Anim4bot/Hardware/Motherboard - Rev2.pdf

## SWITCHES & LEDS

ACTUATORS | SENSORS

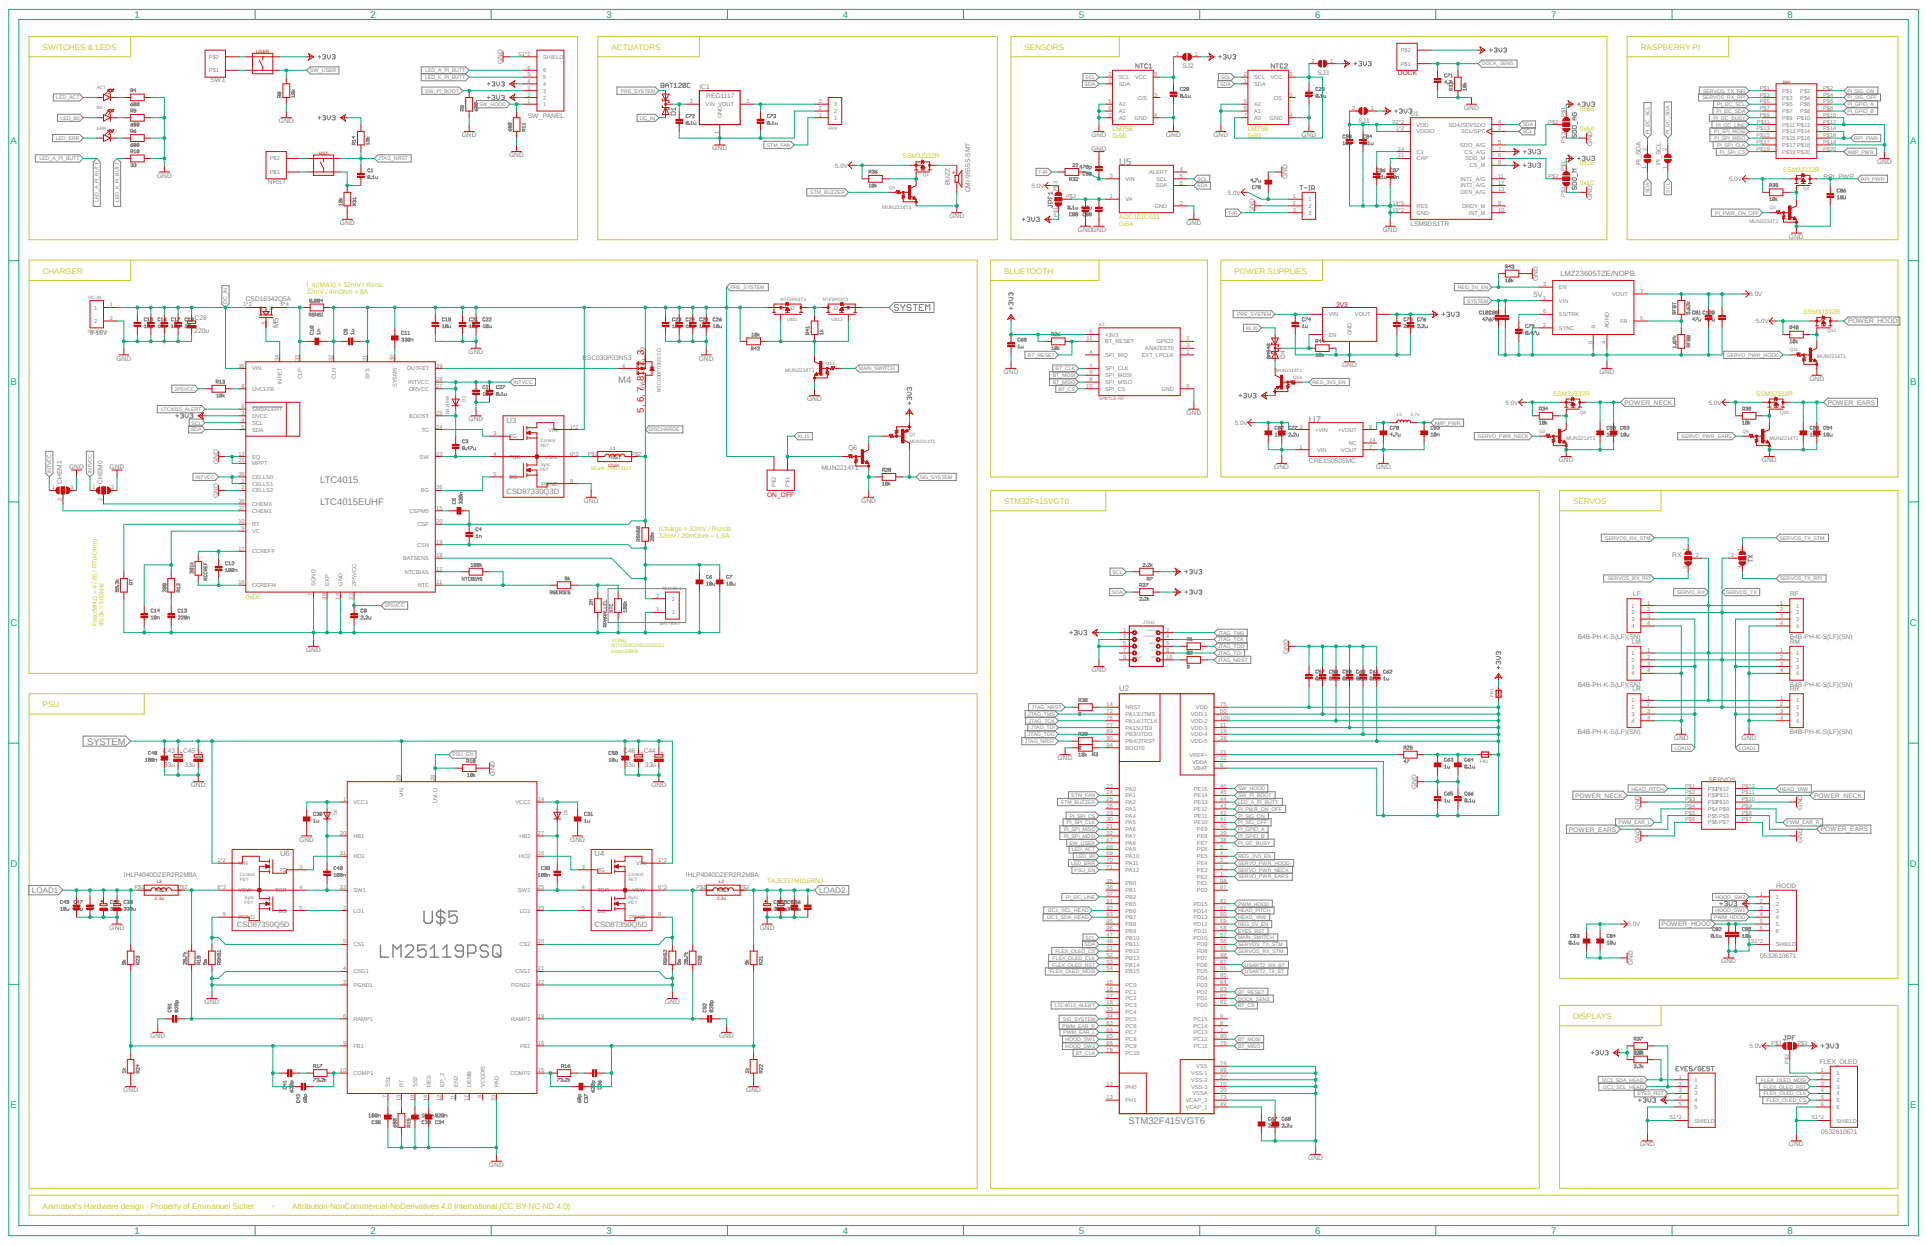
[picture p1: page 1]

Fosc(MHz) = 47.65 / RT(kOhm)
