Anim4bot/Hardware/Motherboard - Rev2.brd

## EAGLE design Motherboard - Rev2.brd (2019-11-18)

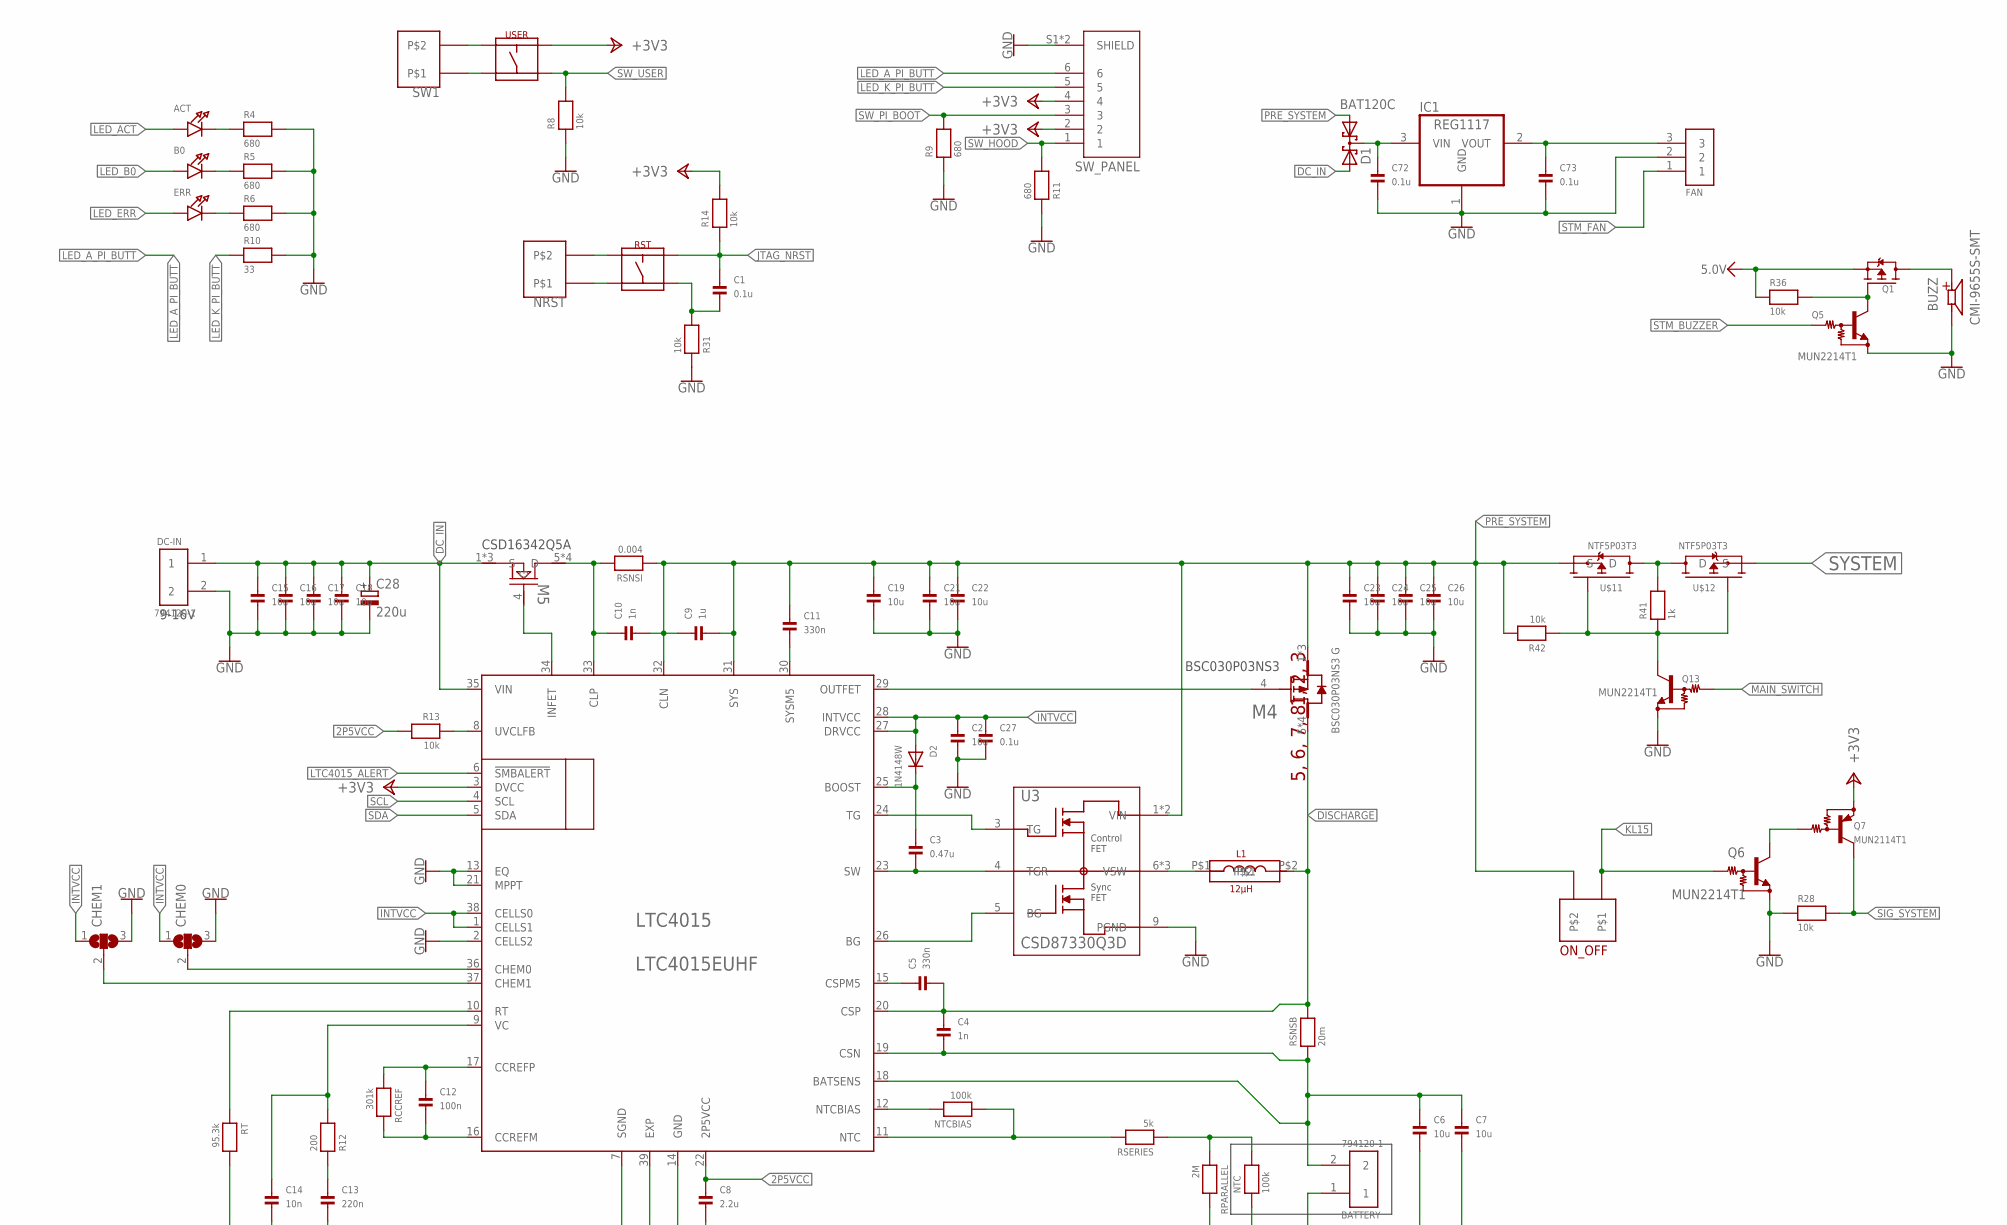
[picture p2: schematic Motherboard - Rev2.sch, part in row 1, column 1]

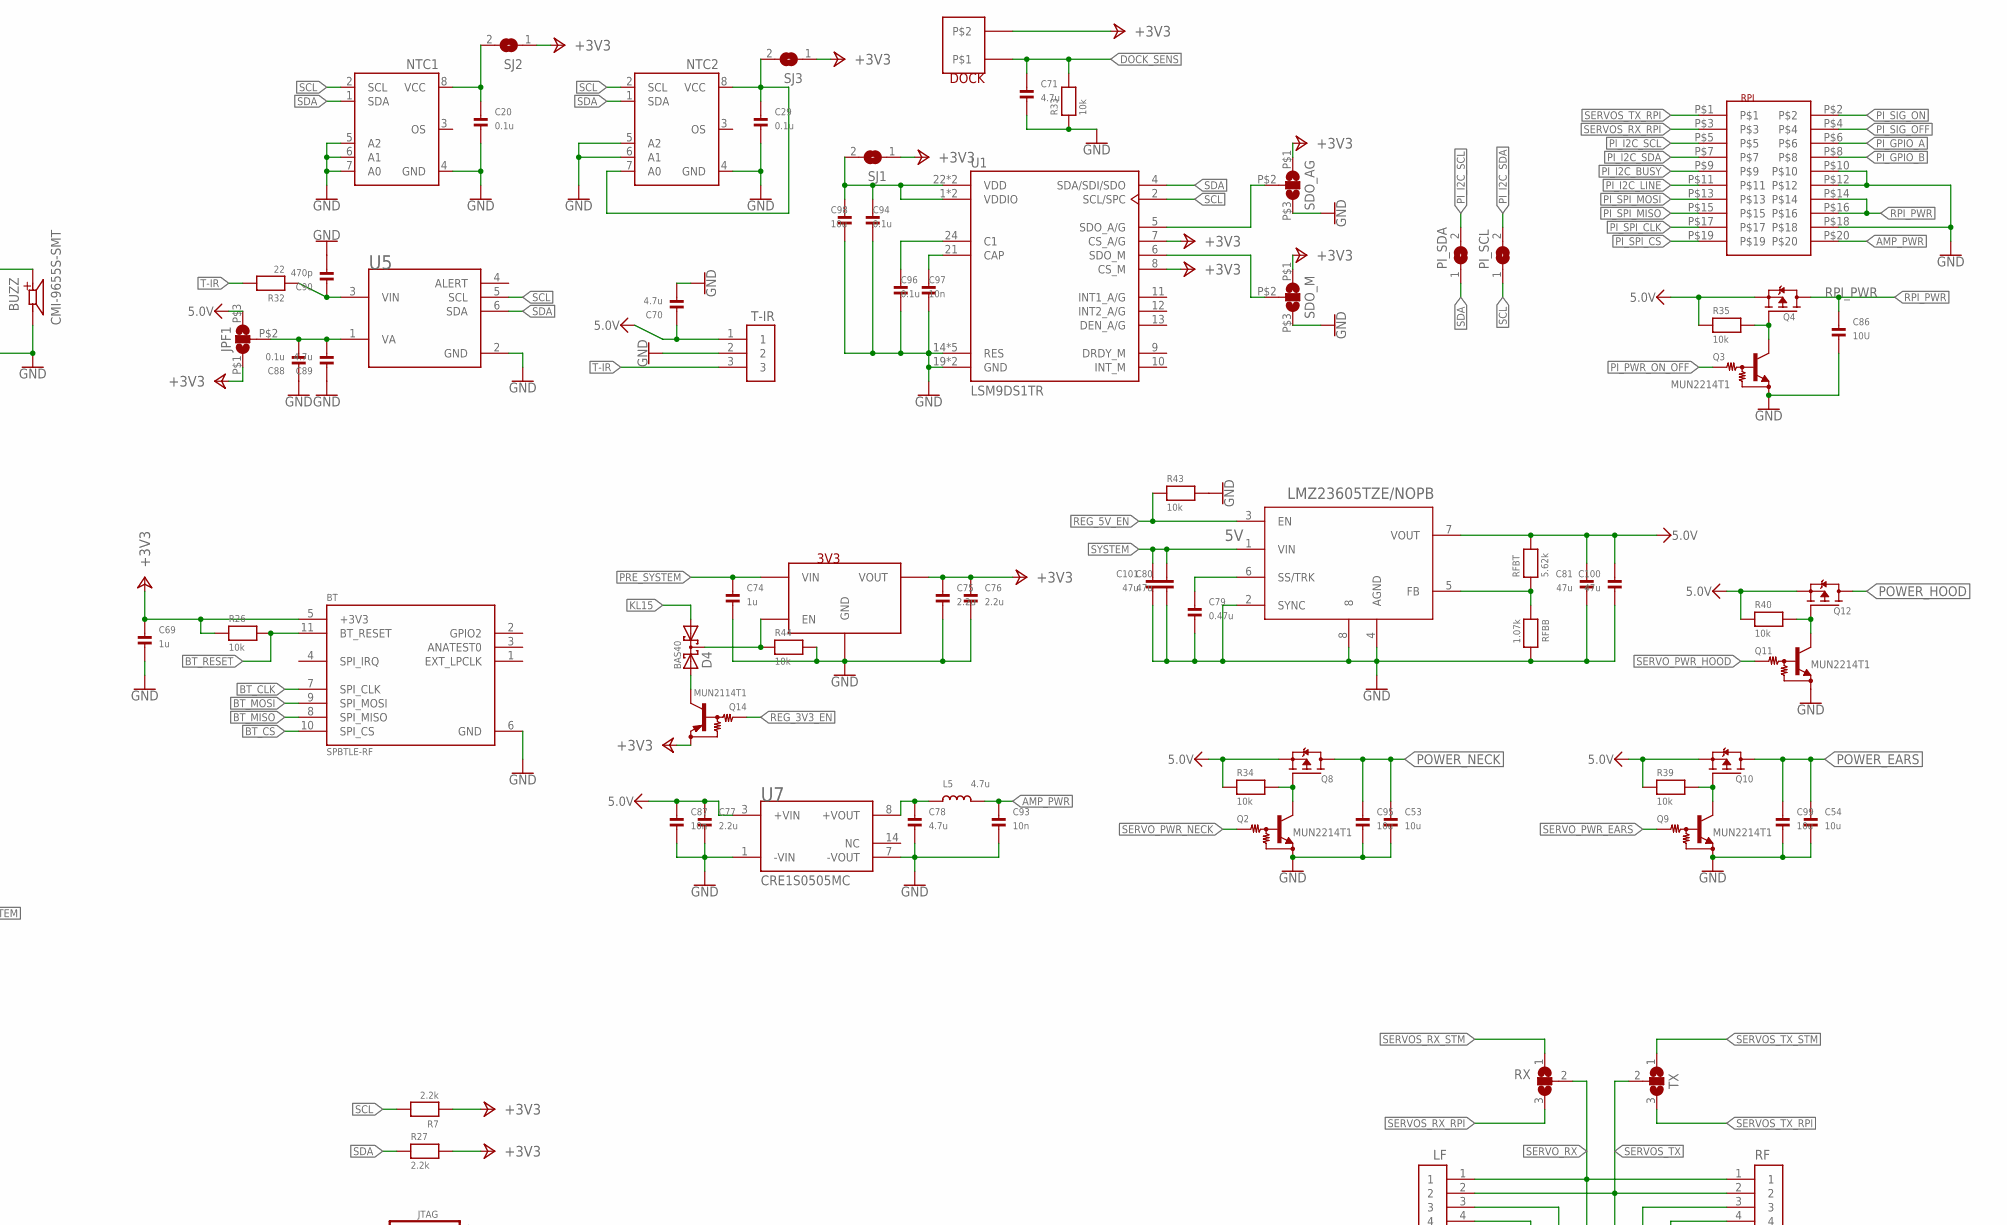
[picture p3: schematic Motherboard - Rev2.sch, part in row 1, column 2]

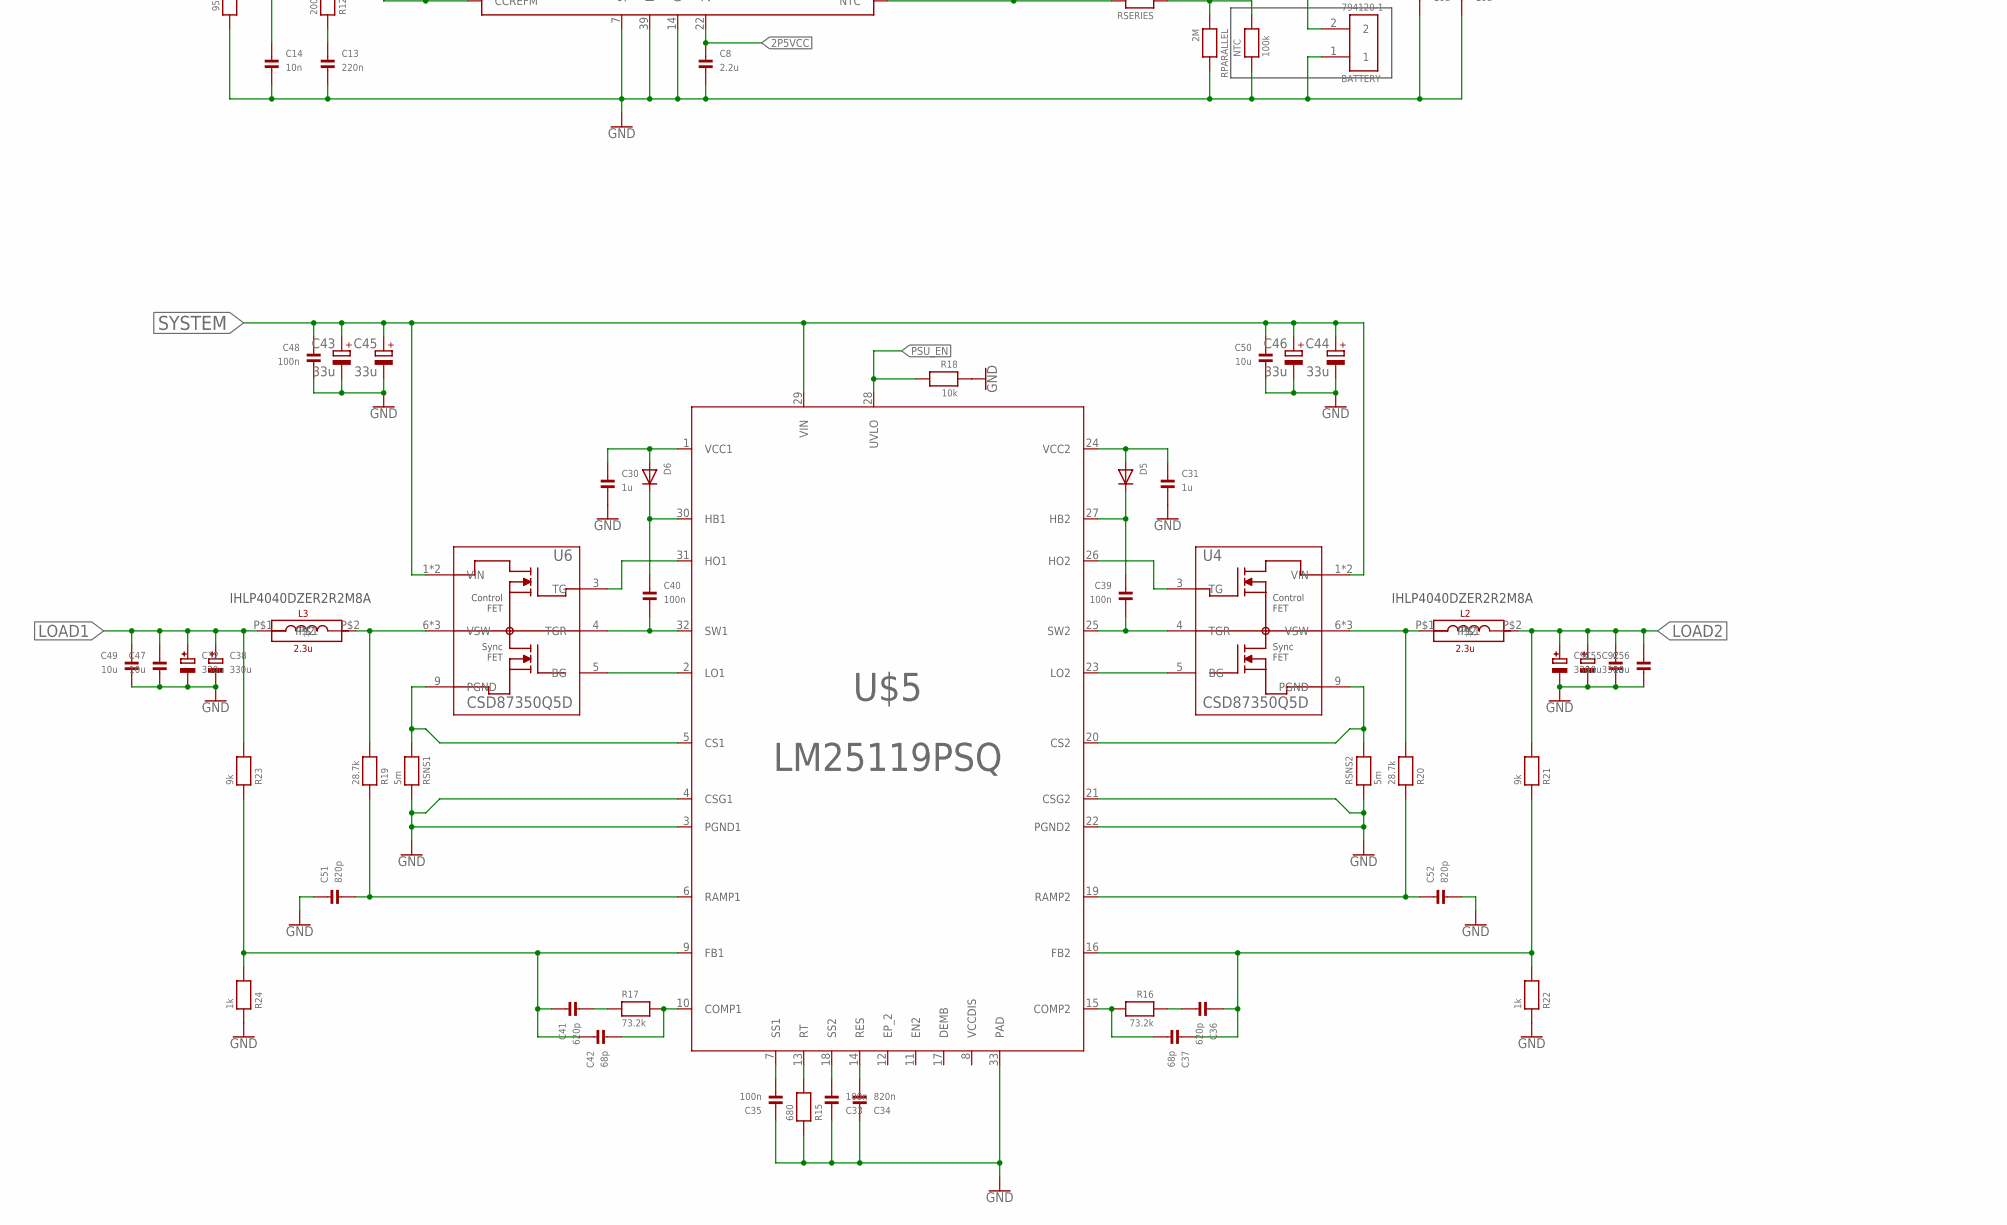
[picture p4: schematic Motherboard - Rev2.sch, part in row 2, column 1]

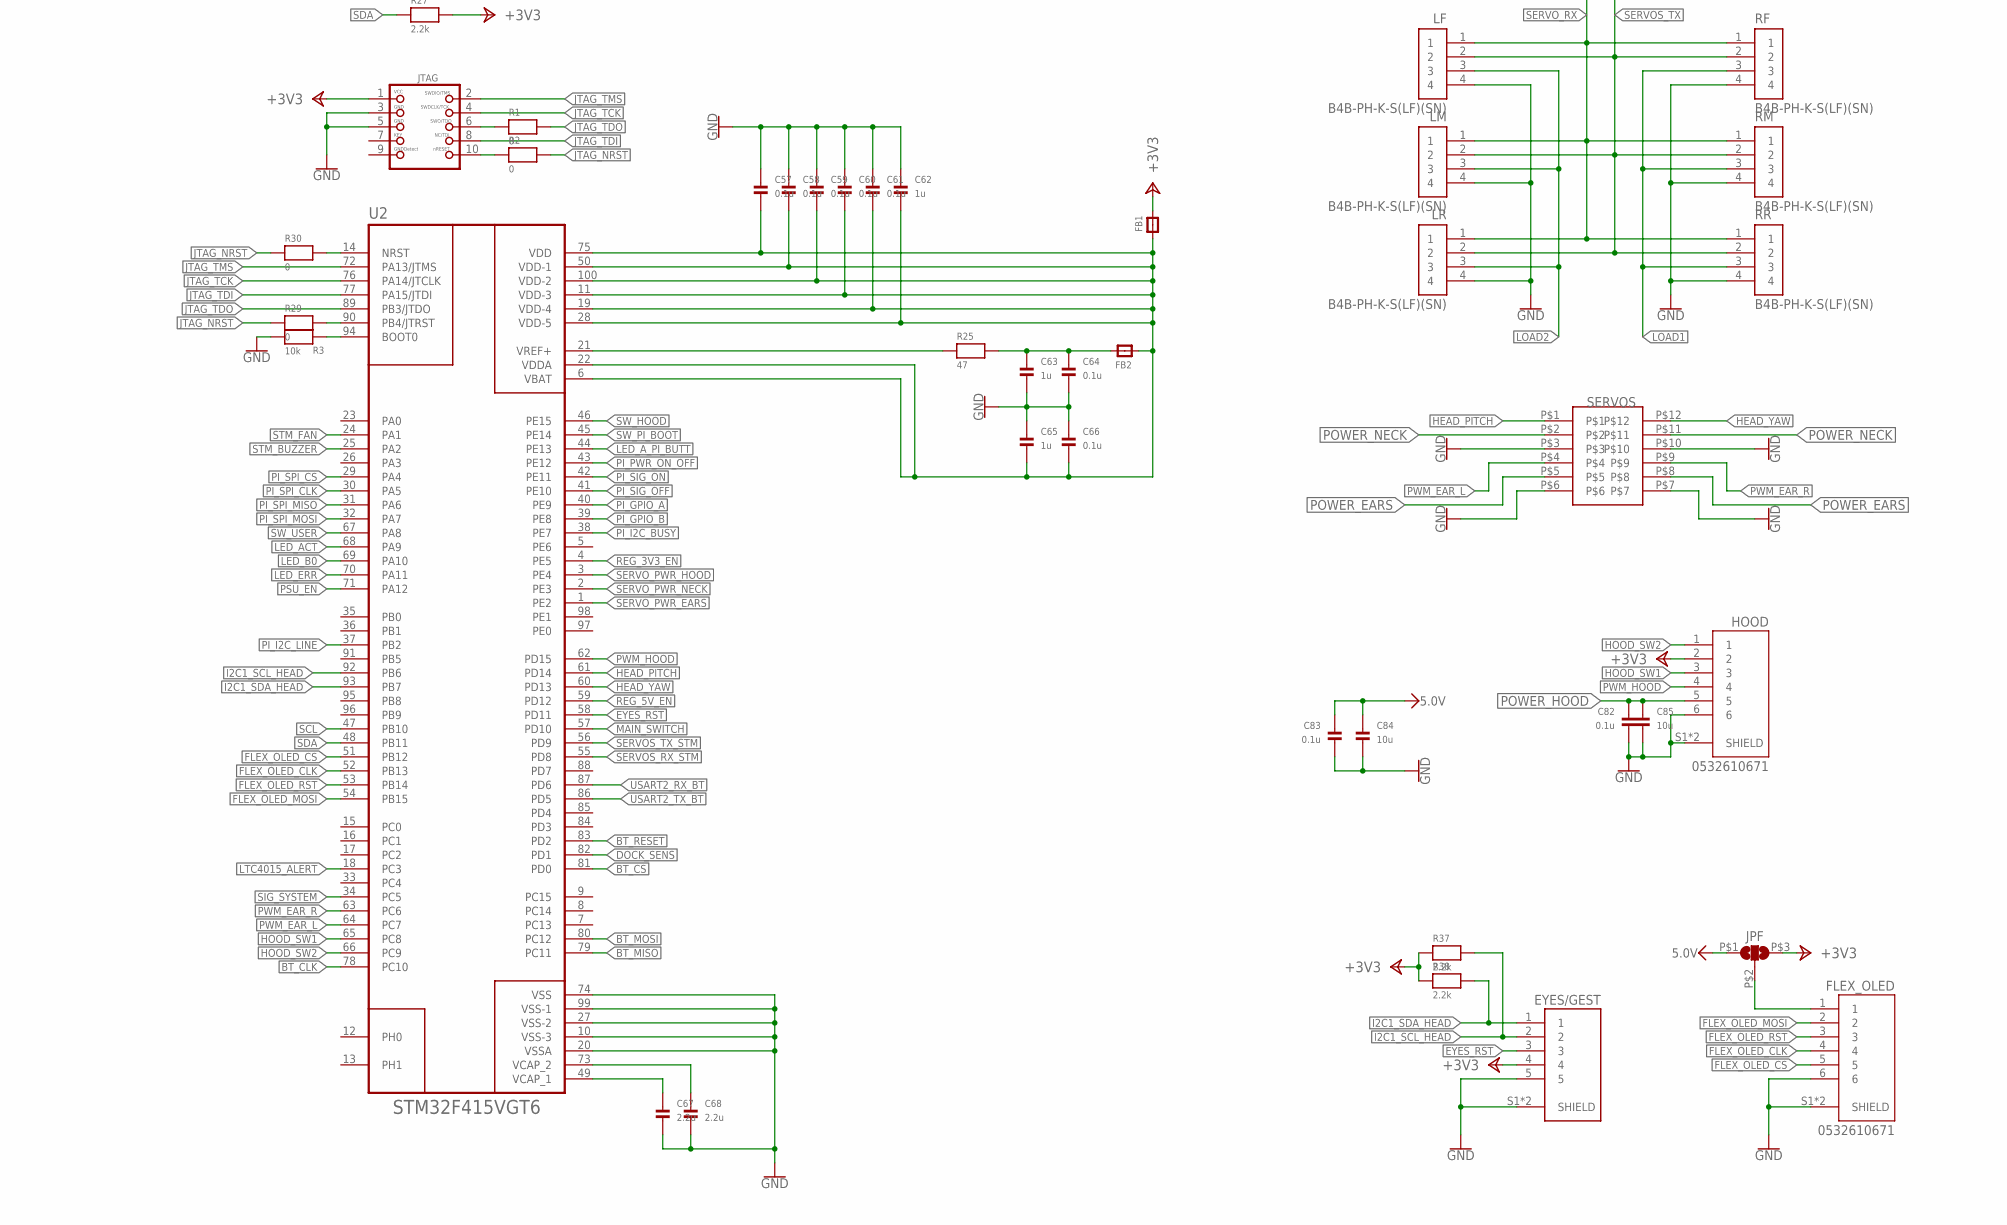
[picture p5: schematic Motherboard - Rev2.sch, part in row 2, column 2]

Parts:
3V3: NCP5500DT-33.50-RKG
5V: LMZ23605TZE/NOPB; TZA07A
ACT: LED0805; CHIPLED_0805
B0: LED0805; CHIPLED_0805
BATTERY: 794120-1; TE_794120-1
BT: SPBTLE-RF; XCVR_SPBTLE-RF
BUZZ: CMI-9655S-SMT; CUI_CMI-9655S-SMT
C1, C20, C27, C29, C57, C58, C59, C60, C61, C64, C66, C72, C73, C82, C83, C88, C94, C96: 0.1u; 0805
C2, C98: 10u; 0805
C3, C79: 0.47u; 0805
C4, C10: 1n; 0805
C5, C11: 330n; 0805
C6, C7, C15, C16, C17, C18, C19, C21, C22, C23, C24, C25, C26, C47, C49, C50, C53, C54, C55, C56, C84, C85, C95, C99: 10u; 1206
C8, C67, C68, C75, C76, C77: 2.2u; 0805
C9, C30, C31, C62, C63, C65, C69, C74: 1u; 0805
C12, C33, C35, C39, C40: 100n; 0805
C13: 220n; 0805
C14, C87, C93, C97: 10n; 0805
C28: 220u; UD-10X10_NICHICON
C32, C38, C91, C92: 330u; EIA7343-31/D-R
C34: 820n; 0805
C36, C41: 620p; 0805
C37, C42: 68p; 0805
C43, C44, C45, C46: 33u; UD-6,3X7,7_NICHICON
C48: 100n; 1206
C51, C52: 820p; 0805
C70, C71, C78, C89: 4.7u; 0805
C80, C81, C100, C101: 47u; 1206
C86: 10U; 0805
C90: 470p; 0805
CHEM0, CHEM1: SJ2W; SJ_2
D1: BAT120C; SOT223
D2: 1N4148W; SOD-123
D4: BAS40; SOT23
D5, D6: DIODESOD-123; SOD-123
DC-IN: 794120-1; TE_794120-1
DOCK: MOLEX_53398
ERR: LED0805; CHIPLED_0805
EYES/GEST: 0532610571; MOLEX_0532610571
FAN: 0532610371; MOLEX_0532610371
FB1, FB2: FERRITE_0805; _0805
FLEX_OLED: 0532610671; MOLEX_0532610671
HOOD: 0532610671; MOLEX_0532610671
IC1: REG1117; SOT223
JPF, JPF1: SJ2WSJ_3; SJ_3
JTAG: JTAG-CORTEXM3; 2X05_1.27MM_SMT
L1: 12µH; SRR1210-680MTR
L2, L3: 2.3u; SRR1210-680MTR
L5: 4.7u; 0805
LF: B4B-PH-K-S(LF)(SN); JST_B4B-PH-K-S(LF)(SN)
LM: B4B-PH-K-S(LF)(SN); JST_B4B-PH-K-S(LF)(SN)
LR: B4B-PH-K-S(LF)(SN); JST_B4B-PH-K-S(LF)(SN)
LTC4015: LTC4015EUHF; QFN50P700X500X80-39N
M4: INFINEON_BSC030P03NS3_GINFINEON_BSC030P03NS3_G_0_0; INFINEON_BSC030P03NS3_G_0
M5: CSD16342Q5A-REV2; DQJ8
NRST: MOLEX_53398
NTC: 100k; 1206
NTC1, NTC2: TEMP_LM75B; TSSOP8
NTCBIAS: 100k; 0805
ON_OFF: MOLEX_53398
PI_SCL: SOLDERJUMPERREFLOW; SOLDERJUMPER_REFLOW
PI_SDA: SOLDERJUMPERREFLOW; SOLDERJUMPER_REFLOW
Q1, Q4, Q8, Q10, Q12: MOSFET-PWIDE; SOT23-WIDE
Q2, Q3, Q5, Q6, Q9, Q11, Q13: MUN2214T1; SC59-BEC
Q7, Q14: MUN2114T1; SC59-BEC
R1, R2, R29, R30: 0; 0805
R3, R8, R13, R14, R18, R26, R28, R31, R33, R34, R35, R36, R39, R40, R42, R43, R44: 10k; 0805
R4, R5, R6, R9, R11, R15: 680; 0805
R7, R27, R37, R38: 2.2k; 0805
R10: 33; 0805
R12: 200; 0805
R16, R17: 73.2k; 0805
R19, R20: 28.7k; 0805
R21, R23: 9k; 0805
R22, R24, R41: 1k; 0805
R25: 47; 0805
R32: 22; 0805
RCCREF: 301k; 0805
RF: B4B-PH-K-S(LF)(SN); JST_B4B-PH-K-S(LF)(SN)
RFBB: 1.07k; 0805
RFBT: 5.62k; 0805
RM: B4B-PH-K-S(LF)(SN); JST_B4B-PH-K-S(LF)(SN)
RPARALLEL: 2M; 0805
RPI: DF50-20DP-1V
RR: B4B-PH-K-S(LF)(SN); JST_B4B-PH-K-S(LF)(SN)
RSERIES: 5k; 0805
RSNS1, RSNS2: 5m; 2012
RSNSB: 20m; 2012
RSNSI: 0.004; 2012
RST: MJTP1140ATR
RT: 95.3k; 0805
RX: SJ2W; SJ_2
SDO_AG: SJ2WSJ_3; SJ_3
SDO_M: SJ2WSJ_3; SJ_3
SERVOS: BM12B-ZPDSS-TF
SJ1, SJ2, SJ3: SOLDERJUMPER; SOLDERJUMPER_ARROW_NOPASTE
SW1: MOLEX_53398
SW_PANEL: 0532610671; MOLEX_0532610671
T-IR: 0532610371; MOLEX_0532610371
TX: SJ2W; SJ_2
U1: LSM9DS1TR; PQFN43P300X350X102-24N
U2: STM32F415VGT6; QFP50P1600X1600X160-100N
U3: CSD87330Q3D; DQZ8_1P8X2P7
U4, U6: CSD87350Q5D; DQY8_3P2X4P3
U5: TEXAS_INSTRUMENTS_ADC101C021CIMK-NOPBTEXAS_INSTRU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; TEXAS_INSTRUMENTS_ADC101C021CIMK-NOPB_0
U7: CRE1S0505MC; SOIC254P1110X700-5N
U$5: LM25119PSQ; SQA32A
U$11, U$12: NTF5P03T3; SOT223
USER: MJTP1140ATR

Connections:
2P5VCC: C8.1, LTC4015.22 (2P5VCC), R13.2
5.0V: 5V.7 (VOUT), C70.1, C77.1, C81.1, C83.1, C84.1, C87.1, C100.1, JPF.P$1 (1), JPF1.P$3 (3), Q1.2 (S), Q4.2 (S), Q8.2 (S), Q10.2 (S), Q12.2 (S), R34.1, R35.1, R36.1, R39.1, R40.1, RFBT.2, T-IR.1, U7.3 (+VIN)
5V_FAN: C73.1, FAN.3, IC1.2 (VOUT)
+3V3: 3V3.VOUT, BT.5 (+3V3), C69.1, C75.1, C76.1, DOCK.P$2, EYES/GEST.4, FB1.2, HOOD.2, JPF.P$3 (3), JPF1.P$1 (1), JTAG.1, LTC4015.3 (DVCC), Q7.E, Q14.E, R7.1, R14.2, R26.1, R27.2, R37.1, R38.1, SDO_AG.P$1 (1), SDO_M.P$1 (1), SJ1.1, SJ2.1, SJ3.1, SW_PANEL.2, SW_PANEL.4, U1.7 (CS_A/G), U1.8 (CS_M), USER.P$2
AMP_PWR: C93.1, L5.2, RPI.P$20
BATT: BATTERY.2, C4.2, C6.1, C7.1, LTC4015.18 (BATSENS), LTC4015.19 (CSN), RSNSB.1
BG: LTC4015.26 (BG), U3.5 (BG)
BT_CLK: BT.7 (SPI_CLK), U2.78 (PC10)
BT_CS: BT.10 (SPI_CS), U2.81 (PD0)
BT_MISO: BT.8 (SPI_MISO), U2.79 (PC11)
BT_MOSI: BT.9 (SPI_MOSI), U2.80 (PC12)
BT_RESET: BT.11 (BT_RESET), R26.2, U2.83 (PD2)
CCREFM: C12.2, LTC4015.16 (CCREFM), RCCREF.2
CCREFP: C12.1, LTC4015.17 (CCREFP), RCCREF.1
CHEM0: CHEM0.2, LTC4015.36 (CHEM0)
CHEM1: CHEM1.2, LTC4015.37 (CHEM1)
CLP: C10.1, LTC4015.33 (CLP), M5.5 (D), M5.6 (D), M5.7 (D), M5.8 (D), RSNSI.2
COMP1: C42.2, R17.2, U$5.10 (COMP1)
COMP2: C37.2, R16.2, U$5.15 (COMP2)
CS1: RSNS1.2, U6.9 (PGND), U$5.5 (CS1)
CS2: RSNS2.2, U4.9 (PGND), U$5.20 (CS2)
DC_IN: C15.1, C16.1, C17.1, C18.1, C28.+, D1.3 (A2), DC-IN.1, LTC4015.35 (VIN), M5.1 (S), M5.2 (S), M5.3 (S)
DISCHARGE: C4.1, C5.2, L1.P$2, LTC4015.20 (CSP), M4.5 (2_DRAIN), M4.6 (2_DRAIN), M4.7 (2_DRAIN), M4.8 (2_DRAIN), RSNSB.2
DOCK_SENS: C71.1, DOCK.P$1, R33.2, U2.82 (PD1)
EYES_RST: EYES/GEST.3, U2.58 (PD11)
FB1: C41.1, C42.1, R23.1, R24.2, U$5.9 (FB1)
FB2: C36.1, C37.1, R21.1, R22.2, U$5.16 (FB2)
FLEX_OLED_CLK: FLEX_OLED.4, U2.52 (PB13)
FLEX_OLED_CS: FLEX_OLED.5, U2.51 (PB12)
FLEX_OLED_MOSI: FLEX_OLED.2, U2.54 (PB15)
FLEX_OLED_RST: FLEX_OLED.3, U2.53 (PB14)
GND: 3V3.GND, 5V.2 (SYNC), 5V.4 (AGND), 5V.8, BATTERY.1, BT.6 (GND), BUZZ.N, C2.2, C6.2, C7.2, C8.2, C13.2, C14.2, C15.2, C16.2, C17.2, C18.2, C19.2, C20.2, C21.2, C22.2, C23.2, C24.2, C25.2, C26.2, C27.2, C28.-, C29.2, C30.2, C31.2, C32.-, C33.1, C34.1, C35.1, C38.-, C43.-, C44.-, C45.-, C46.-, C47.2, C48.2, C49.2, C50.2, C51.1, C52.2, C53.2, C54.2, C55.2, C56.2, C57.1, C58.1, C59.1, C60.1, C61.1, C62.1, C63.2, C64.2, C65.1, C66.1, C67.2, C68.2, C69.2, C70.2, C71.2, C72.2, C73.2, C74.2, C75.2, C76.2, C77.2, C78.2, C79.2, C80.2, C81.2, C82.2, C83.2, C84.2, C85.2, C86.2, C87.2, C88.1, C89.1, C90.2, C91.-, C92.-, C93.2, C94.2, C95.2, C96.2, C97.2, C98.2, C99.2, C100.2, C101.2, CHEM0.3, CHEM1.3, DC-IN.2, EYES/GEST.5, EYES/GEST.S1 (SHIELD), EYES/GEST.S2 (SHIELD), FAN.2, FLEX_OLED.6, FLEX_OLED.S1 (SHIELD), FLEX_OLED.S2 (SHIELD), HOOD.6, HOOD.S1 (SHIELD), HOOD.S2 (SHIELD), IC1.1 (GND), JTAG.3, JTAG.5, LF.4, LM.4, LR.4, LTC4015.2 (CELLS2), LTC4015.7 (SGND), LTC4015.13 (EQ), LTC4015.14 (GND), LTC4015.21 (MPPT), LTC4015.39 (EXP), NTC.1, NTC1.4 (GND), NTC1.5 (A2), NTC1.6 (A1), NTC1.7 (A0), NTC2.4 (GND), NTC2.5 (A2), NTC2.6 (A1), Q2.E, Q3.E, Q5.E, Q6.E, Q9.E, Q11.E, Q13.E, R3.1, R4.2, R5.2, R6.2, R8.1, R9.1, R10.2, R11.1, R15.1, R18.1, R22.1, R24.1, R28.1, R31.1, R33.1, R43.2, R44.2, RF.4, RFBB.2, RM.4, RPARALLEL.2, RPI.P$10, RPI.P$12, RPI.P$18, RR.4, RSNS1.1, RSNS2.1, RT.2, SDO_AG.P$3 (3), SDO_M.P$3 (3), SERVOS.P$3, SERVOS.P$6, SERVOS.P$7, SERVOS.P$10, SW_PANEL.S1 (SHIELD), SW_PANEL.S2 (SHIELD), T-IR.2, U1.14 (RES), U1.15 (RES), U1.16 (RES), U1.17 (RES), U1.18 (RES), U1.19 (GND), U1.20 (GND), U2.10 (VSS-3), U2.20 (VSSA), U2.27 (VSS-2), U2.74 (VSS), U2.99 (VSS-1), U3.9 (PGND), U5.2 (GND), U7.1 (-VIN), U7.7 (-VOUT), U$5.3 (PGND1), U$5.4 (CSG1), U$5.21 (CSG2), U$5.22 (PGND2), U$5.33 (PAD)
HEAD_PITCH: SERVOS.P$1, U2.61 (PD14)
HEAD_YAW: SERVOS.P$12, U2.60 (PD13)
HO1: U6.3 (TG), U$5.31 (HO1)
HO2: U4.3 (TG), U$5.26 (HO2)
HOOD_SW1: HOOD.3, U2.65 (PC8)
HOOD_SW2: HOOD.1, U2.66 (PC9)
I2C1_SCL_HEAD: EYES/GEST.2, R37.2, U2.92 (PB6)
I2C1_SDA_HEAD: EYES/GEST.1, R38.2, U2.93 (PB7)
INFET: LTC4015.34 (INFET), M5.4 (G)
INTVCC: C2.1, C27.1, CHEM0.1, CHEM1.1, D2.A, LTC4015.1 (CELLS1), LTC4015.27 (DRVCC), LTC4015.28 (INTVCC), LTC4015.38 (CELLS0)
JTAG_NRST: C1.1, R2.2, R14.1, R29.1, R30.1, RST.P$2
JTAG_TCK: JTAG.4, U2.76 (PA14/JTCLK)
JTAG_TDI: JTAG.8, U2.77 (PA15/JTDI)
JTAG_TDO: R1.2, U2.89 (PB3/JTDO)
JTAG_TMS: JTAG.2, U2.72 (PA13/JTMS)
KL15: D4.1 (A1), ON_OFF.P$1, Q6.B
LED_ACT: ACT.A, U2.68 (PA9)
LED_A_PI_BUTT: SW_PANEL.6, U2.44 (PE13)
LED_B0: B0.A, U2.69 (PA10)
LED_ERR: ERR.A, U2.70 (PA11)
LED_K_PI_BUTT: R10.1, SW_PANEL.5
LO1: U6.5 (BG), U$5.2 (LO1)
LO2: U4.5 (BG), U$5.23 (LO2)
LOAD1: C32.+, C38.+, C47.1, C49.1, L3.P$1, R23.2, RF.3, RM.3, RR.3
LOAD2: C55.1, C56.1, C91.+, C92.+, L2.P$2, LF.3, LM.3, LR.3, R21.2
LTC4015_ALERT: LTC4015.6 (!SMBALERT), U2.18 (PC3)
MAIN_SWITCH: Q13.B, U2.57 (PD10)
unnamed: C90.1, R32.1, U5.3 (VIN)
unnamed: NRST.P$1, RST.P$4
unnamed: Q2.C, Q8.1 (G), R34.2
unnamed: Q3.C, Q4.1 (G), R35.2
unnamed: ERR.C, R6.1
unnamed: B0.C, R5.1
unnamed: JTAG.6, R1.1
unnamed: JTAG.10, R2.1
unnamed: ACT.C, R4.1
unnamed: C72.1, D1.4 (K1K2), IC1.3 (VIN)
unnamed: NRST.P$2, RST.P$1
unnamed: Q9.C, Q10.1 (G), R39.2
unnamed: C78.1, L5.1, U7.8 (+VOUT)
unnamed: LTC4015.12 (NTCBIAS), NTCBIAS.2
unnamed: Q11.C, Q12.1 (G), R40.2
unnamed: C3.1, D2.C, LTC4015.25 (BOOST)
unnamed: R29.2, U2.90 (PB4/JTRST)
unnamed: R3.2, U2.94 (BOOT0)
unnamed: R41.2, U$11.4 (D), U$12.4 (D)
unnamed: C5.1, LTC4015.15 (CSPM5)
unnamed: Q13.C, R41.1, R42.1, U$11.1 (G), U$12.1 (G)
unnamed: Q1.1 (G), Q5.C, R36.2
unnamed: Q6.C, Q7.B
unnamed: R30.2, U2.14 (NRST)
unnamed: SW1.P$1, USER.P$4
unnamed: 3V3.EN, D4.3 (C), R44.1
unnamed: C13.1, R12.1
unnamed: D4.2 (A2), Q14.C
unnamed: C1.2, R31.2, RST.P$3
unnamed: C68.1, U2.73 (VCAP_2)
unnamed: LTC4015.8 (UVCLFB), R13.1
unnamed: R15.2, U$5.13 (RT)
unnamed: C67.1, U2.49 (VCAP_1)
unnamed: BUZZ.P, Q1.3 (D)
unnamed: R25.1, U2.21 (VREF+)
unnamed: C36.2, R16.1
unnamed: C57.2, C58.2, C59.2, C60.2, C61.2, C62.2, C65.2, C66.2, FB1.1, FB2.1, U2.6 (VBAT), U2.11 (VDD-3), U2.19 (VDD-4), U2.22 (VDDA), U2.28 (VDD-5), U2.50 (VDD-1), U2.75 (VDD), U2.100 (VDD-2)
unnamed: C63.1, C64.1, FB2.2, R25.2
unnamed: C39.1, D5.C, U$5.27 (HB2)
unnamed: NTC.2, RPARALLEL.1, RSERIES.1
unnamed: C96.1, U1.24 (C1)
unnamed: C97.1, U1.21 (CAP)
unnamed: SDO_M.P$2 (2), U1.6 (SDO_M)
unnamed: SDO_AG.P$2 (2), U1.5 (SDO_A/G)
unnamed: FLEX_OLED.1, JPF.P$2 (2)
unnamed: C88.2, C89.2, JPF1.P$2 (2), U5.1 (VA)
unnamed: SW1.P$2, USER.P$1
unnamed: C40.1, D6.C, U$5.30 (HB1)
unnamed: 5V.5 (FB), RFBB.1, RFBT.1
unnamed: C20.1, NTC1.8 (VCC), SJ2.2
unnamed: C41.2, R17.1
unnamed: C94.1, C98.1, SJ1.2, U1.1 (VDDIO), U1.3 (VDDIO), U1.22 (VDD), U1.23 (VDD)
unnamed: 5V.6 (SS/TRK), C79.1
unnamed: C29.1, NTC2.7 (A0), NTC2.8 (VCC), SJ3.2
unnamed: L3.P$2, R19.2, U6.6 (VSW), U6.7 (VSW), U6.8 (VSW)
unnamed: L2.P$1, R20.2, U4.6 (VSW), U4.7 (VSW), U4.8 (VSW)
NTC: LTC4015.11 (NTC), NTCBIAS.1, RSERIES.2
OUTFET: LTC4015.29 (OUTFET), M4.4 (GATE)
PI_GPIO_A: RPI.P$6, U2.40 (PE9)
PI_GPIO_B: RPI.P$8, U2.39 (PE8)
PI_I2C_BUSY: RPI.P$9, U2.38 (PE7)
PI_I2C_LINE: RPI.P$11, U2.37 (PB2)
PI_I2C_SCL: PI_SDA.2, RPI.P$5
PI_I2C_SDA: PI_SCL.2, RPI.P$7
PI_PWR_ON_OFF: Q3.B, U2.43 (PE12)
PI_SIG_OFF: RPI.P$4, U2.41 (PE10)
PI_SIG_ON: RPI.P$2, U2.42 (PE11)
PI_SPI_CLK: RPI.P$17, U2.30 (PA5)
PI_SPI_CS: RPI.P$19, U2.29 (PA4)
PI_SPI_MISO: RPI.P$15, U2.31 (PA6)
PI_SPI_MOSI: RPI.P$13, U2.32 (PA7)
POWER_EARS: C54.1, C99.1, Q10.3 (D), SERVOS.P$5, SERVOS.P$8
POWER_HOOD: C82.1, C85.1, HOOD.5, Q12.3 (D)
POWER_NECK: C53.1, C95.1, Q8.3 (D), SERVOS.P$2, SERVOS.P$11
PRE_SYSTEM: 3V3.VIN, C9.1, C9.2, C10.2, C11.1, C19.1, C21.1, C22.1, C23.1, C24.1, C25.1, C26.1, C74.1, D1.1 (A1), LTC4015.31 (SYS), LTC4015.32 (CLN), M4.1 (2_SOURCE), M4.2 (2_SOURCE), M4.3 (2_SOURCE), ON_OFF.P$2, R42.2, RSNSI.1, U3.1 (VIN), U3.2 (VIN), U$11.3 (S)
PSU_EN: R18.2, U2.71 (PA12), U$5.28 (UVLO)
PWM_EAR_L: SERVOS.P$4, U2.64 (PC7)
PWM_EAR_R: SERVOS.P$9, U2.63 (PC6)
PWM_HOOD: HOOD.4, U2.62 (PD15)
RAMP1: C51.2, R19.1, U$5.6 (RAMP1)
RAMP2: C52.1, R20.1, U$5.19 (RAMP2)
REG_3V3_EN: Q14.B, U2.4 (PE5)
REG_5V_EN: 5V.3 (EN), R43.1, U2.59 (PD12)
RES: C34.2, U$5.14 (RES)
RPI_PWR: C86.1, Q4.3 (D), RPI.P$14, RPI.P$16
RT: LTC4015.10 (RT), RT.1
SCL: LTC4015.4 (SCL), NTC1.2 (SCL), NTC2.2 (SCL), PI_SCL.1, R7.2, U1.2 (SCL/SPC), U2.47 (PB10), U5.5 (SCL)
SDA: LTC4015.5 (SDA), NTC1.1 (SDA), NTC2.1 (SDA), PI_SDA.1, R27.1, U1.4 (SDA/SDI/SDO), U2.48 (PB11), U5.6 (SDA)
SERVOS_RX_RPI: RPI.P$3, RX.3
SERVOS_RX_STM: RX.1, U2.55 (PD8)
SERVOS_TX: LF.2, LM.2, LR.2, RF.2, RM.2, RR.2, TX.2
SERVOS_TX_RPI: RPI.P$1, TX.3
SERVOS_TX_STM: TX.1, U2.56 (PD9)
SERVO_PWR_EARS: Q9.B, U2.1 (PE2)
SERVO_PWR_HOOD: Q11.B, U2.3 (PE4)
SERVO_PWR_NECK: Q2.B, U2.2 (PE3)
SERVO_RX: LF.1, LM.1, LR.1, RF.1, RM.1, RR.1, RX.2
SIG_SYSTEM: Q7.C, R28.2, U2.34 (PC5)
SS1: C35.2, U$5.7 (SS1)
SS2: C33.2, U$5.18 (SS2)
STM_BUZZER: Q5.B, U2.25 (PA2)
STM_FAN: FAN.1, U2.24 (PA1)
SW1: C40.2, U6.4 (TGR), U$5.32 (SW1)
SW2: C39.2, U4.4 (TGR), U$5.25 (SW2)
SW_HOOD: R11.2, SW_PANEL.1, U2.46 (PE15)
SW_PI_BOOT: R9.2, SW_PANEL.3, U2.45 (PE14)
SW_USER: R8.2, U2.67 (PA8), USER.P$3
SYSMS: C11.2, LTC4015.30 (SYSM5)
SYSTEM: 5V.1 (VIN), C43.+, C44.+, C45.+, C46.+, C48.1, C50.1, C80.1, C101.1, U4.1 (VIN), U4.2 (VIN), U6.1 (VIN), U6.2 (VIN), U$5.29 (VIN), U$12.3 (S)
T-IR: R32.2, T-IR.3
TG: LTC4015.24 (TG), U3.3 (TG)
TGR: C3.2, LTC4015.23 (SW), U3.4 (TGR)
USART2_RX_BT: U2.87 (PD6)
USART2_TX_BT: U2.86 (PD5)
VC: C14.1, LTC4015.9 (VC), R12.2
VCC1: C30.1, D6.A, U$5.1 (VCC1)
VCC2: C31.1, D5.A, U$5.24 (VCC2)
VSW: L1.P$1, U3.6 (VSW), U3.7 (VSW), U3.8 (VSW)

Notes on the sheet:
CSD16342Q5A
BSC030P03NS3
9-16V
IHLP4040DZER2R2M8A

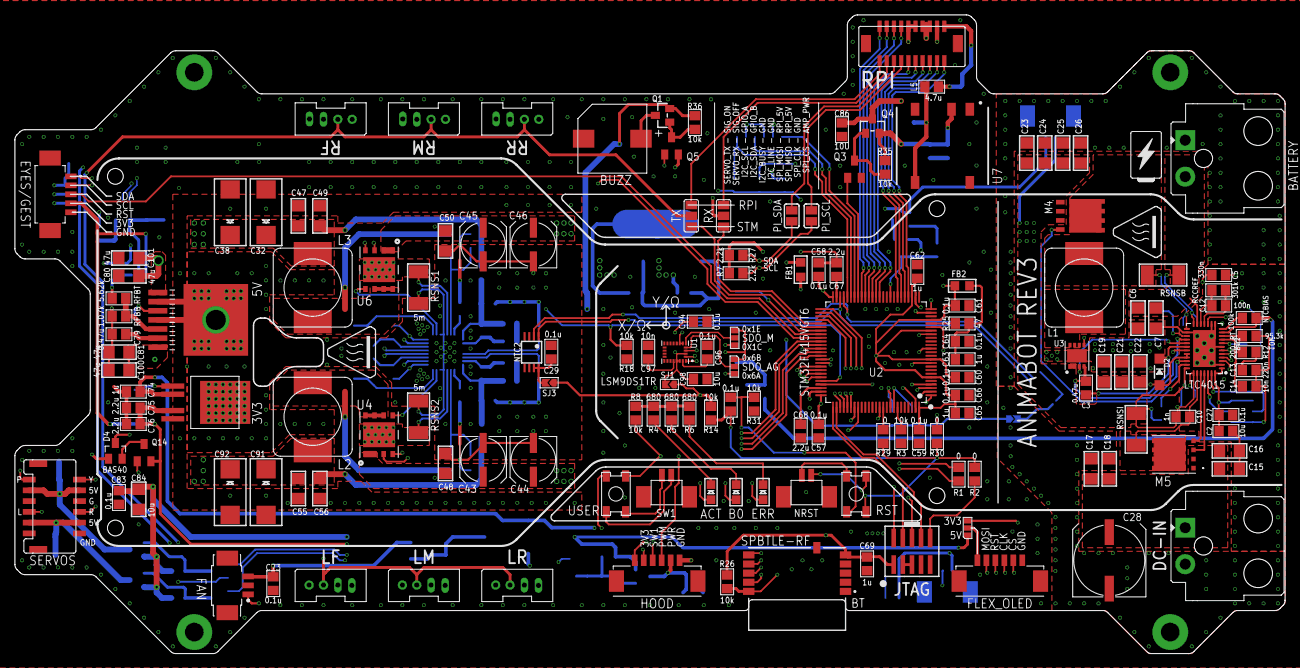
[picture p6: board Motherboard - Rev2.brd from above]

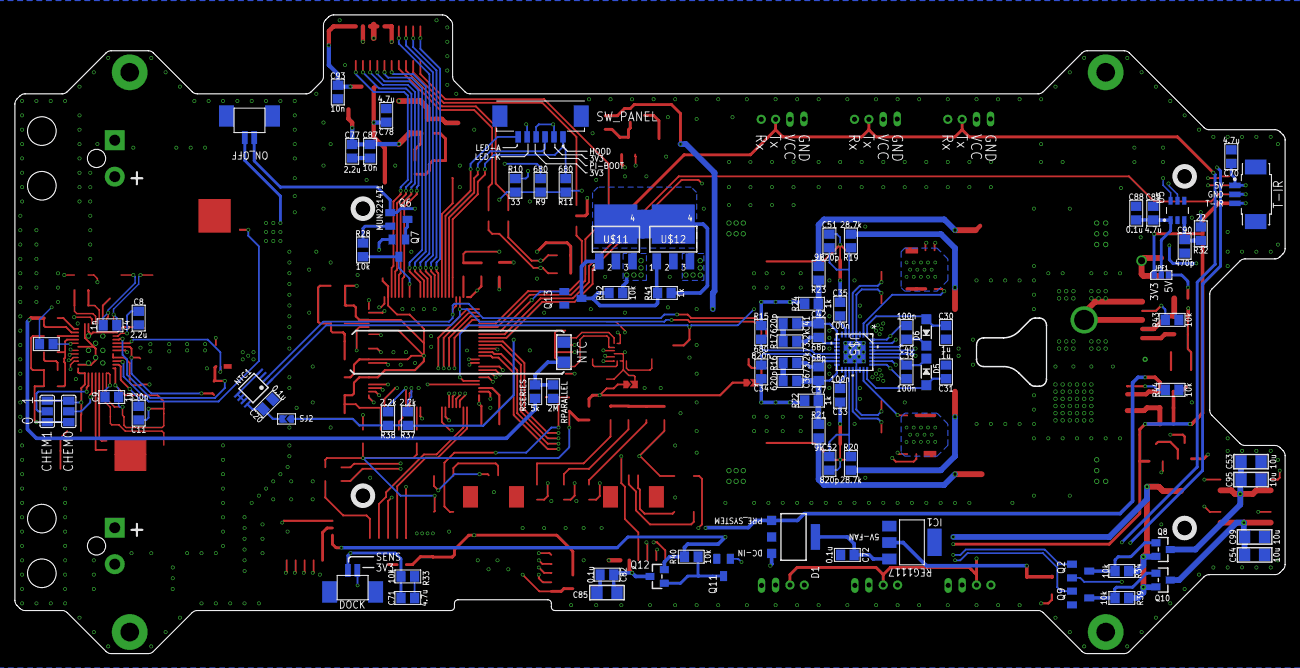
[picture p7: board Motherboard - Rev2.brd from below]

Board: 4 copper layers, 177.0 x 89.0 mm, 241 parts (88 on the bottom side), 175 nets.
