Anim4bot/Hardware/(notices)

Notices in the files:
Motherboard - Rev2.sch:
Animabot's Hardware design - Property of Emmanuel Sichet - Attribution-NonCommercial-NoDerivatives 4.0 International (CC BY-NC-ND 4.0)
parts and their libraries:
microbuilder: This work is placed in the public domain, and may be freely used for commercial and non-commercial work with the following conditions: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
SparkFun-PowerSymbols: Licensing: Creative Commons ShareAlike 4.0 International - https://creativecommons.org/licenses/by-sa/4.0
